Gwend0lyne/Machine-Pince/README.md

# Projet ARDUINO - Jade Wagner Gwendolyne Bouchard
## Machine à pince
