Gwend0lyne/Machine-Pince/CahierDesCharges.md

# Cahier des charges

Machine à pince qui se pilote à partir d'un joystick :   
- Taille d'environ 50cm² pour la base et 70cm de hauteur
- Joystick avant-arrière: on choisit la profondeur à laquelle on veut être   
- Joystick gauche-droite : Puis on choisit le déplacement horizontal
- Bouton : appuyer pour faire descendre la pince (hauteur de la descente non réglable), elle se referme puis remonte toute seule
- La pince fermée va au-dessus du coin où se trouve la sortie et s'ouvre
- Optionnel : devoir mettre un jeton pour pouvoir jouer
