Gwend0lyne/Machine-Pince/Planning.md

# Planning pour les 8 premières scéances 

1. * Recherche du matériel nécessaire, des composants Arduino   
   * Gwendolyne : Choisir les formes adaptées, pour que les pièces puissent être assemblées les unes avec les autres et adapter ensuite l'esthétique de la machine à pince.   
   * Jade : Définir les mouvements mécaniques nécessaires au bon fonctionnement afin de pouvoir commencer à coder à la séance prochaine.
2. * Gwendolyne : Début du code: déterminer des fonctions principales, reprendre des fonctions déià vues en cours et les adapter si besoin
   * Jade : Début du branchement des moteurs, compréhension générale du fonctionnement de la pince et des éléments de code nécessaires
3. * Développement des codes, chercher les potentielles erreurs ou problèmes auxquels nous devrons faire face
4. * Jade : Continuer le codage, y apporter des détails
   * Gwendolyne : Créer une maquette
5. * Utiliser la maquette pour tester le code dans son ensemble, vérifier que les éléments interagissent entre eux et trouver des solutions informatiques mais aussi physiques
6. * Perfectionner le code, chercher à optimiser les déplacements et préparer le montage final, préparer chaque pièce séparément pour être prêts à assembler
7. * Commencer l'assemblage des éléments
   * Tester le bon fonctionnement
8. * Finaliser l'esthétique de la machine à pince
   * S'assurer qu'il n'y a plus de problèmes
