Gwend0lyne/Machine-Pince/Rapports seances/Bouchard Gwendolyne/Rapport-séance-6-Bouchard-Gwendolyne.pdf

Rapport séance 6

Gwendolyne Bouchard

Ce que j’ai fait avant la séance au fablab

- Code avec la pince qui s’ouvre et se ferme

J’ai testé les angles pour notre pince dans un fichier à part puis j’ai incorporé ces valeurs dans notre code pour que la pince se referme après être descendu pour prendre les peluches puis ce réouvre pour faire tomber les peluches dans le coin.

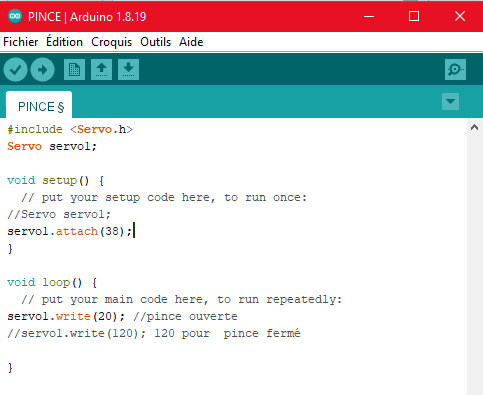
[picture p21: figure]

- Carte Arduino sur le coté

J’ai fait des trous de 3mm sur le bord de notre boite du haut pour pouvoir viser notre carte en haut, au plus proche des moteurs, là où il y aura le plus de câbles.

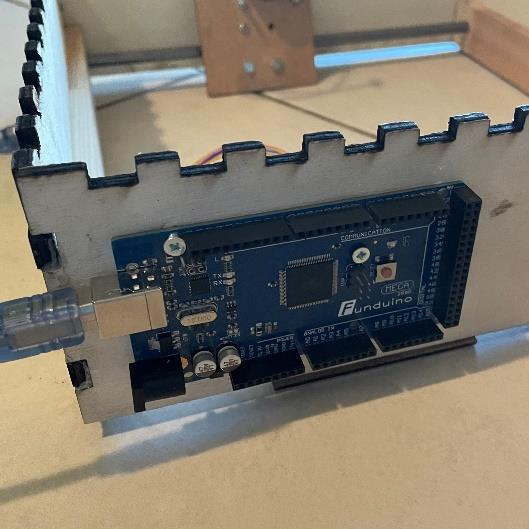
[picture p22: figure]

- Visse qui plaque la courroie

Pour que notre moteur déplace tout le support, il faut que la courrois soit bien plaqué sur notre moteur j’ai donc ajouté des visses avec des morceaux en plastique pour faire cela.

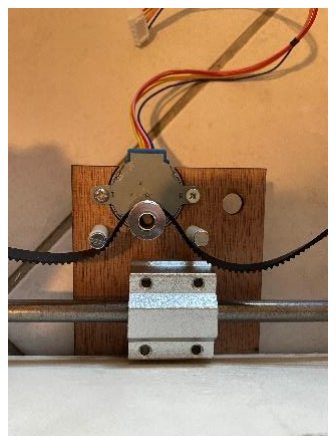
[picture p23: figure]

- Redécoupe du support de droite

En faisant des tests on s’est rendu compte que notre moteur n’était pas assez fort et notre structure pas assez stable pour qu’un seul moteur déplace la barre du milieu. J’ai donc recoupé à l’aide de la découpeuse laser le support en bois que j’avais déjà fait pour la barre du coté droit pour y rajouter la forme d’un moteur. On a donc pris un 4ème moteur qu’on a vissé dessus. Il nous reste à adapter notre code à cette modification.

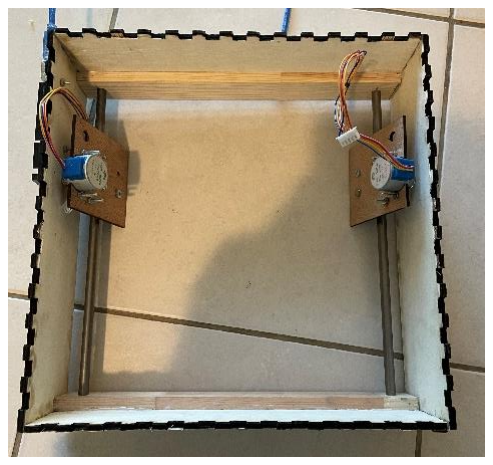
[picture p24: figure]

Ce que j’ai fait pendant la séance

- Soudure

Notre carte Arduino étant tout en haut, les câbles qui viennent du joystick sont à l’opposé. J’ai donc coupé des câbles avec une longueur modulable plus qu’ils puissent traverser la boite du bas, sortir par le trou de derrière, remonté jusqu’à la boite du haut et aller sur le coté pour atteindre la carte Arduino.

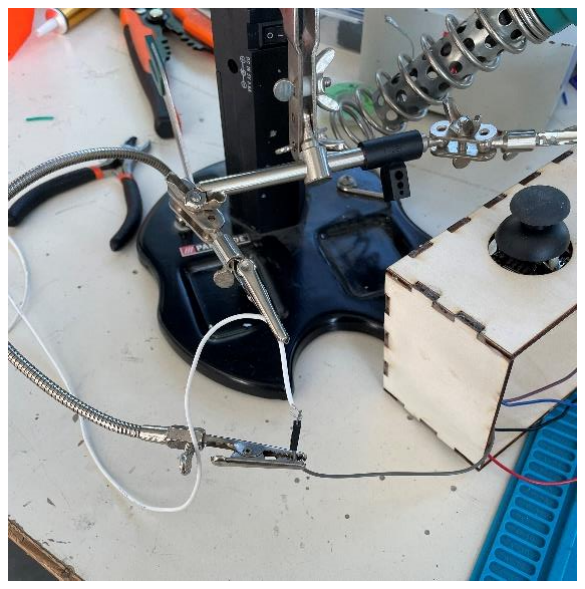
[picture p25: figure]

- Câbles du joystick

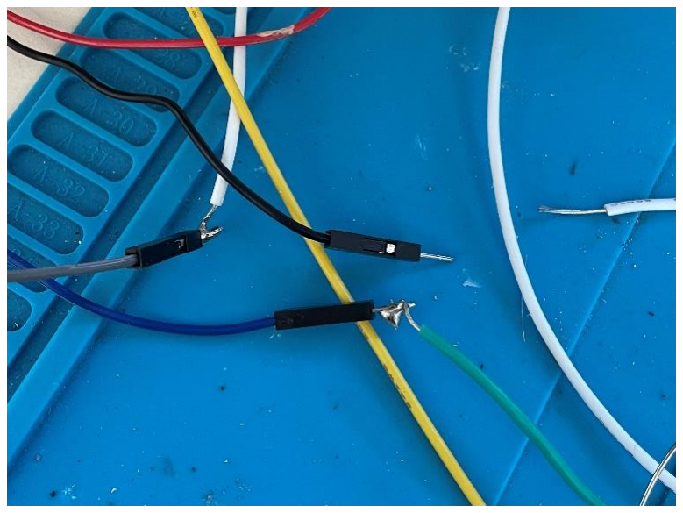
[picture p26: figure]

Notre joystick se situe tout en bas dans une petite boite devant. Il est donc nécessaire que les câbles qui le relis à la carte arduino passe à l’intérieure de la boite du bas puis ressorte derrière, c’est pour cela que j’ai fait des trous dans le coté arrière de ma boite ainsi quand dans la même position dans la planche qui va venir faire tout le fond de notre projet.

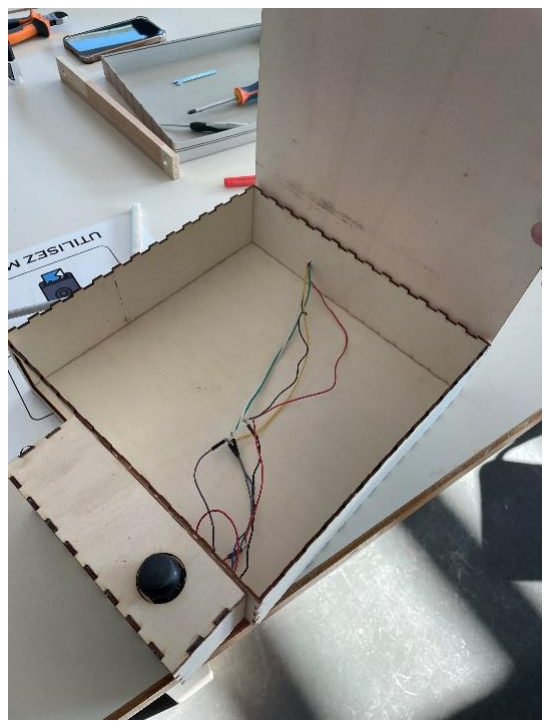
[picture p27: figure]

- Plaque 5V et masse

J’ai demandé une petite plaque avec seulement les 5V et les masses car nous n’utilisons que ça dans notre projet. Je vais la mettre a coté de la carte arduino sur la boite du haut.

- Fixation de la partie des barres du haut

Avec Jade, après avoir changé de barres pour des barres pleines car les vides ne glissaient pas assez (détaillé dans le rapport de Jade) nous avons mit les barres dans des support en bois puis on les a collés à l’aide de colle de bois, pour qu’il reste au bon endroit pendant le temps du séchage nous les avons bloqué à l’aide de serre joint.

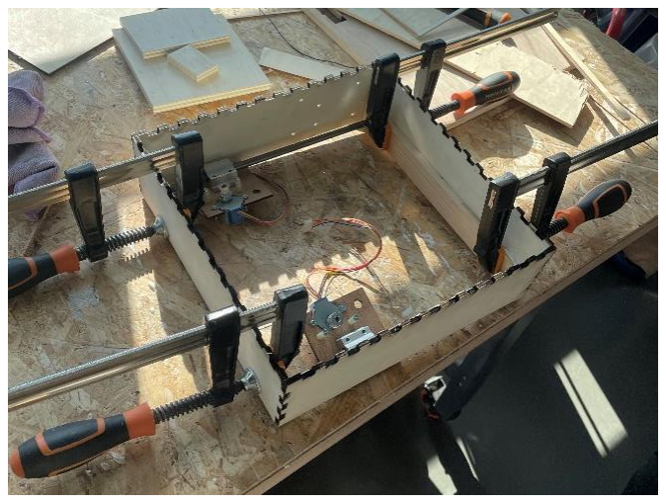
[picture p28: figure]

- Redécoupe des supports entre la boite du haut et la boite du bas

A cause de nos changements de types de barres le poids de la partie du haut à beaucoup augmenté on s’est donc rendu compte que nos support qui était en 3mm n’allait pas être assez stable, je les ai donc remodélisé sur Inkscape pour du bois 5mm (je me suis aidé de Makercase pour faire les encoches même si je ne voulais pas vraiment faire de boite). J’ai ensuite fait la découpe laser avec un bois 5mm.

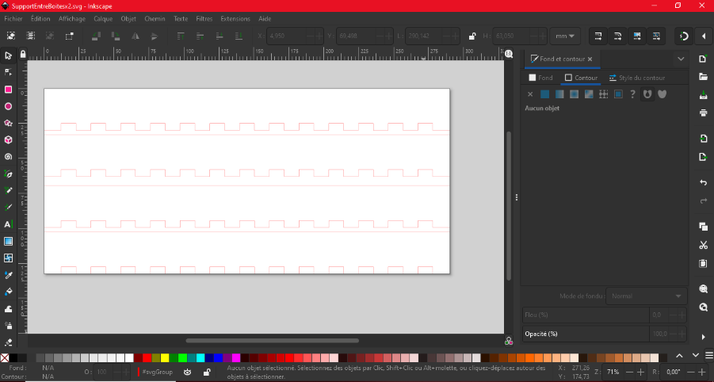
[picture p29: figure]
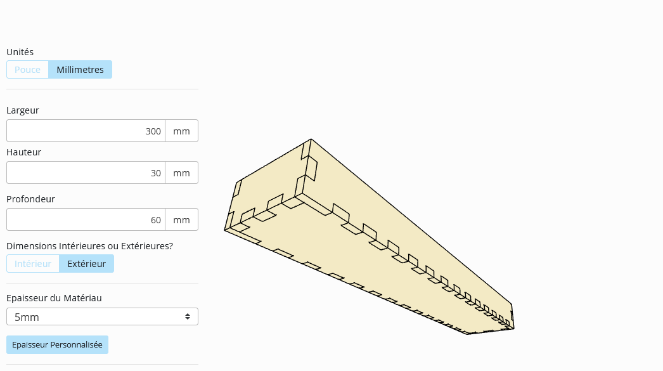
[picture p30: figure]
