Gwend0lyne/Machine-Pince/Rapports seances/Bouchard Gwendolyne/Rapport-séance-4-Bouchard-Gwendolyne.pdf

Rapport séance 4

Gwendolyne Bouchard

- Moteurs

J’ai vissé sur mes 2 moteurs, ceux qui se déplaceront de gauche à droite et d’avant à arrière, un module qui permettra de bouger à l’aide d‘une courroie.

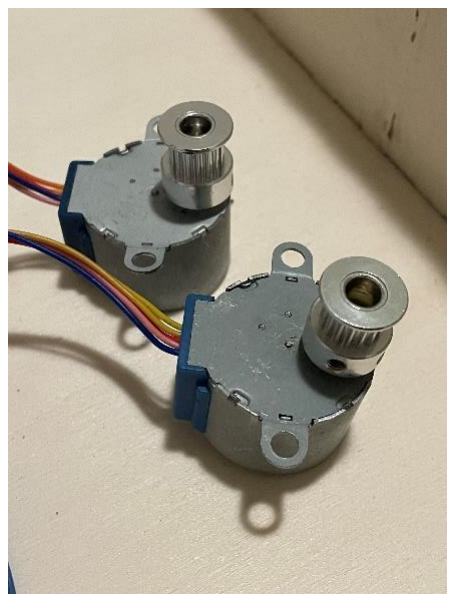
[picture p88: figure]

- Joystick

J’ai trouvé un moyen de bloquer mon joystick qui été jusqu’à présent seulement scotcher sur le haut de la boite, il fallait que je tienne pour pouvoir appuyer sur le bouton sinon il se découlais. Je l’ai bloqué avec un bout de bois qui été une chute pour qu’on puisse appuyer sur bouton.

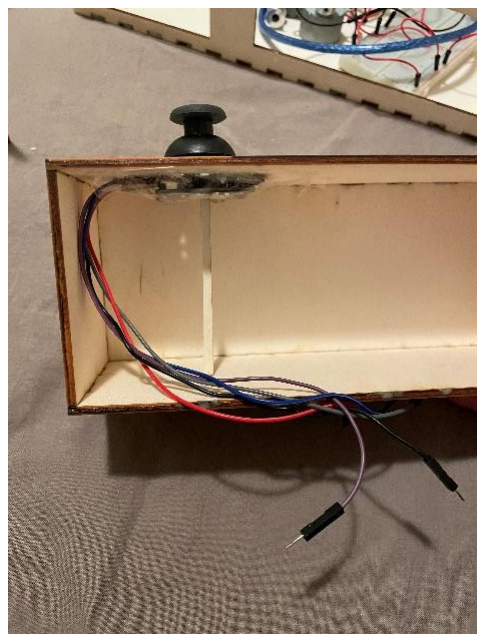
[picture p89: figure]

- Avancement pour la boite

J’ai fait des découpes laser pour pouvoir faire les rebords de la face avant de la boite pour faire du renfort. J’ai aussi découpé des rectangles de bonne taille pour faire le fond et les rebords qui monte à l’endroit où les peluches tombent

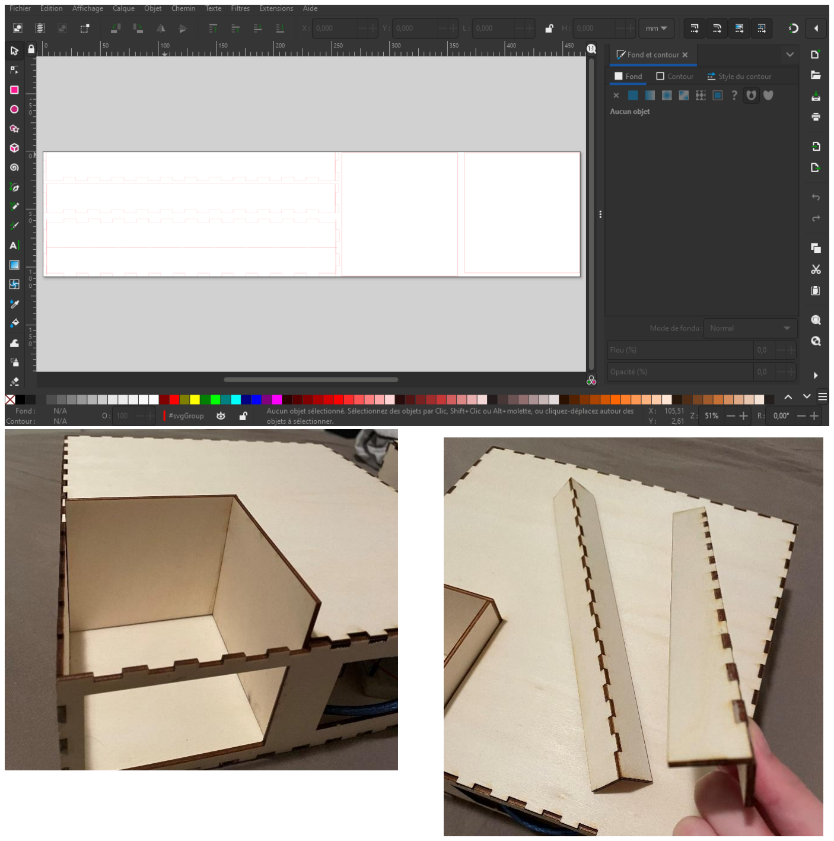
[picture p90: figure]
