Gwend0lyne/Machine-Pince/Machine à pince2.pdf

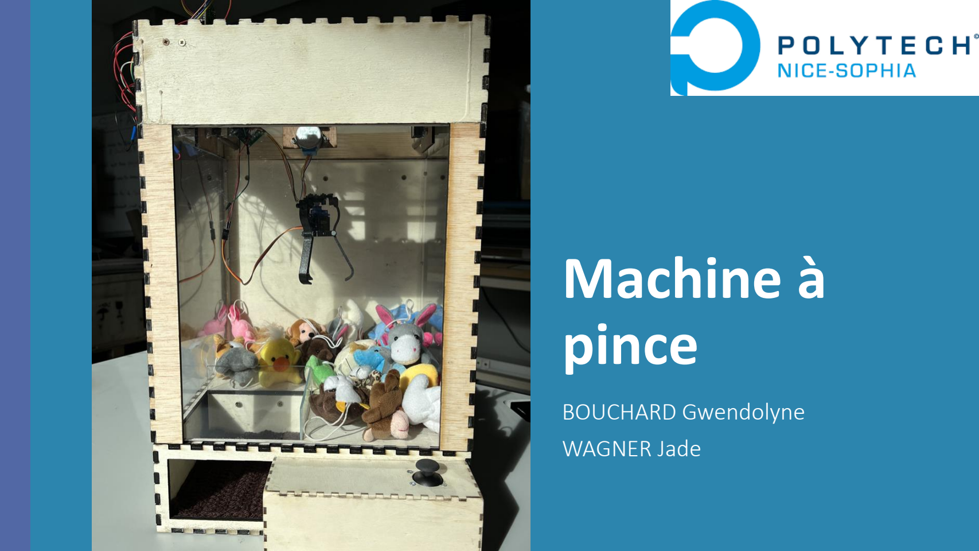
[picture p113: page 1]

# Machine à pince

## BOUCHARD Gwendolyne WAGNER Jade

# Sommaire

2

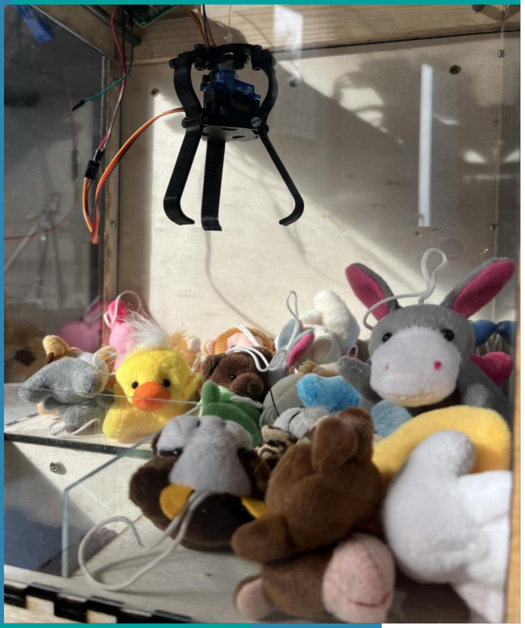
[picture p114: figure]
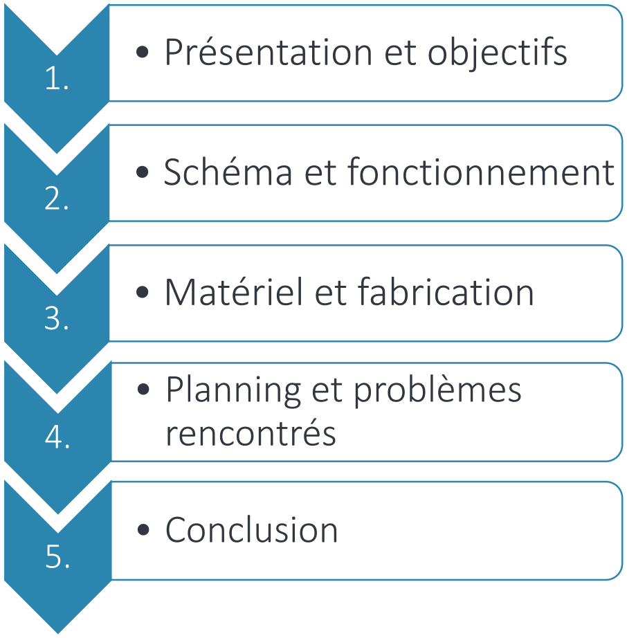
[picture p115: figure]
• Présentation et objectifs; • Schéma et fonctionnement; • Matériel et fabrication; • Planning et problèmes rencontrés; • Conclusion

# 1. Présentation et objectifs

3

## Présentation

## Objectifs

Commandes à partir d’un joystick:

- Déplacements de la pince d’avant en arrière et de droite à gauche.
- Appuyer sur le joystick pour faire descendre la pince. Elle se referme, remonte et retourne au dessus du trou.
- Se déplacer dans l’espace
- Avancée fluide
- Ouverture de la pince au bon moment
- Automatiser le trajet retour
- Ensemble solide

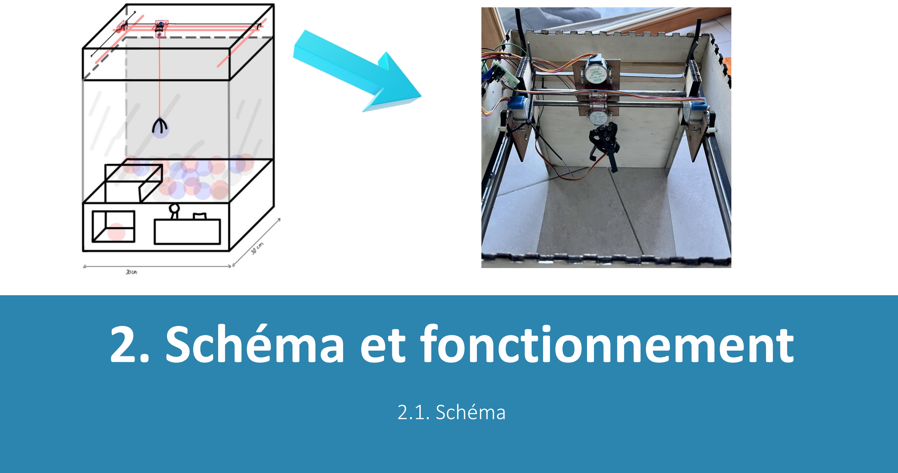
[picture p116: page 4]

# 2. Schéma et fonctionnement

## 2.1. Schéma

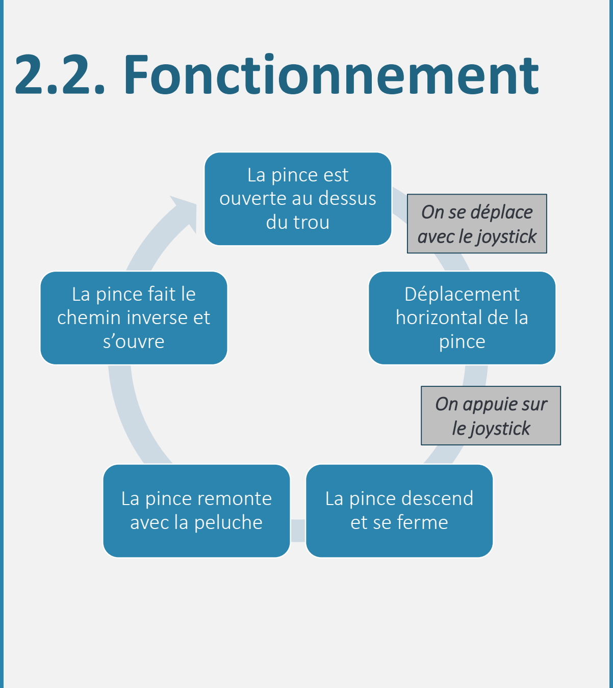
[picture p117: figure]
2.2. Fonctionnement; La pince est ouverte au dessus du trou; Déplacement horizontal de la pince; La pince descend et se ferme; La pince remonte avec la peluche; La pince fait le chemin inverse et s’ouvre; On appuie sur le joystick; On se déplace avec le joystick
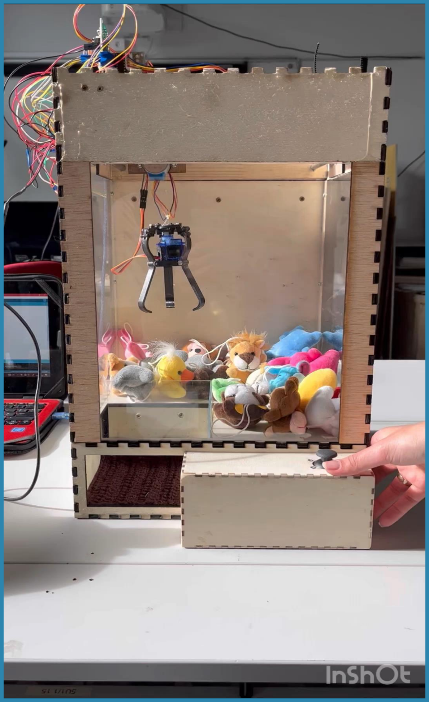
[picture p118: figure]

# 3. Matériel et fabrication

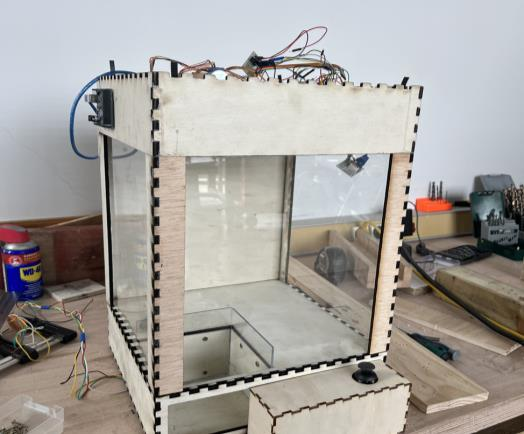
[picture p119: figure]
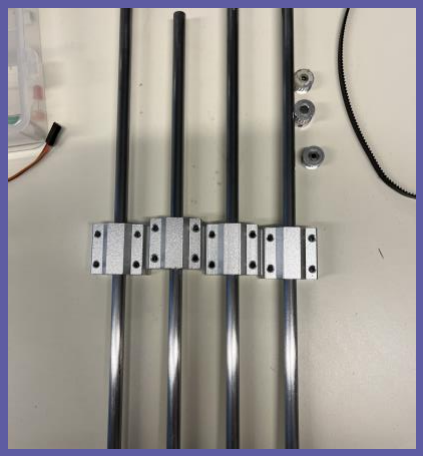
[picture p120: figure]
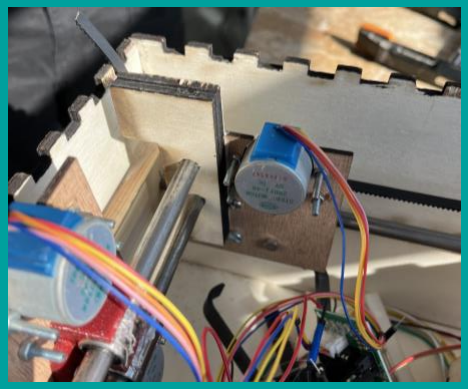
[picture p121: figure]

Découpe de deux
boîtes en bois
contreplaqué de
30cmx30cm et plaques
de plastique
transparentes

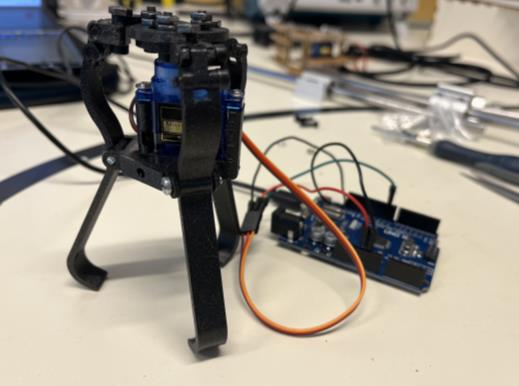
[picture p122: figure]

4 barres métalliques
avec les glissières
adaptées

Quatre moteurs pas à
pas et une pince avec
son servomoteur

Trois courroies, pièces
fixatrices en bois
découpées

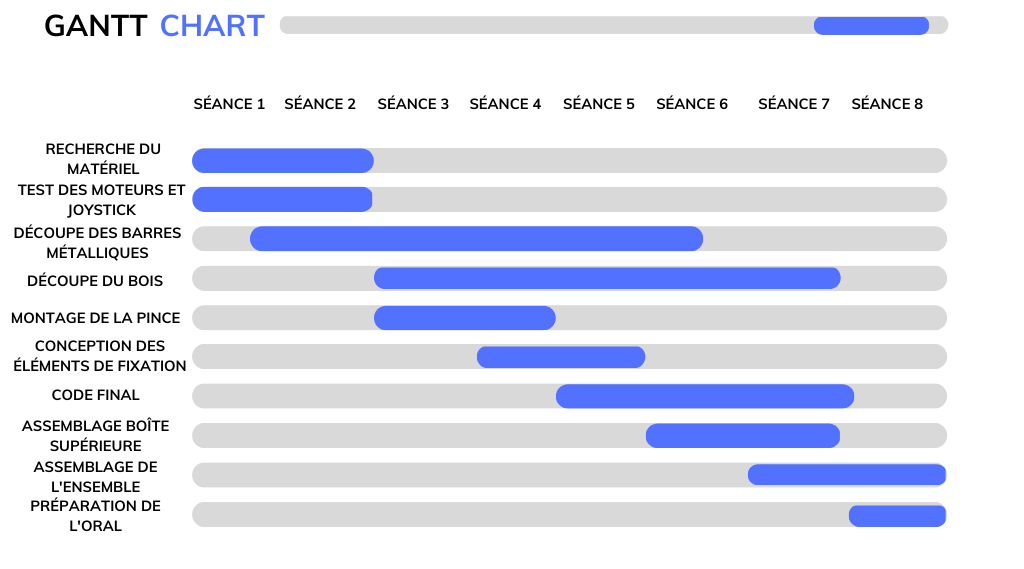
[picture p123: figure]

# 4. Planning, problèmes rencontrés

7

## 4.1. Diagramme de Gantt

# 4.2. Problèmes majeurs rencontrés

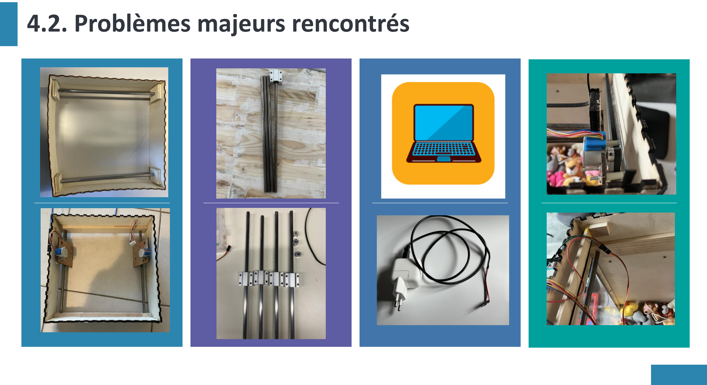
[picture p124: page 8]
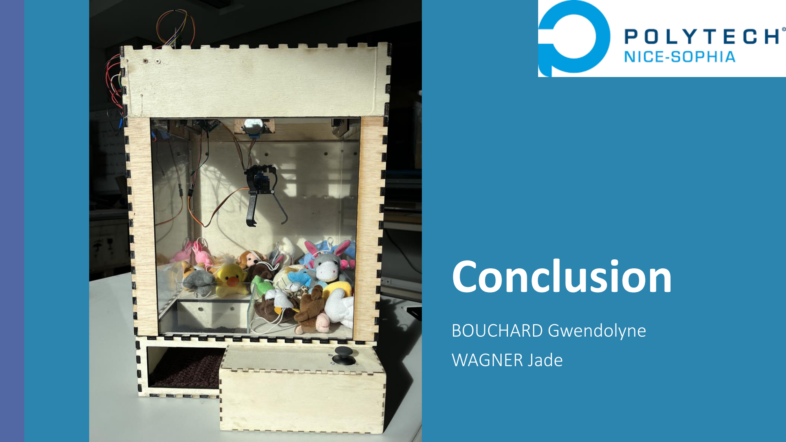
[picture p125: page 9]

# Conclusion

## BOUCHARD Gwendolyne WAGNER Jade
